LIGHT-ON-APPS/LIGTH-ON-DISPLAY/민석님 lcd 핀맵.png

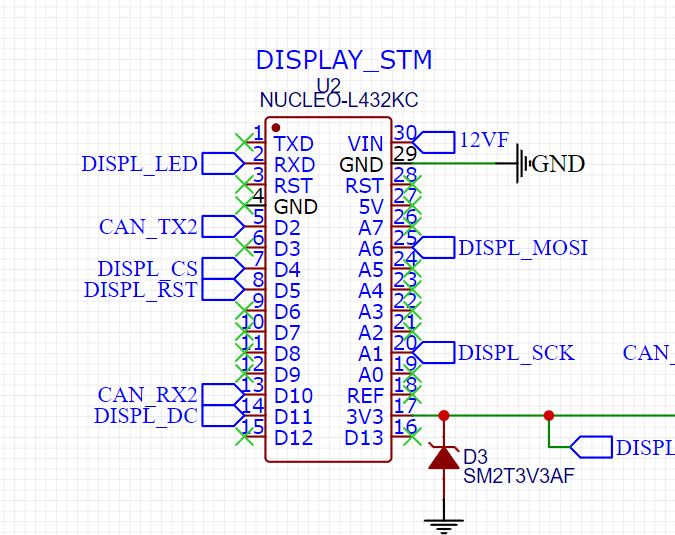
민석님 lcd 핀맵.png
