LIGHT-ON-APPS/LIGTH-ON-DISPLAY/src/common/def.h

/*
 * def.h
 *
 *  Created on: Dec 6, 2020
 *      Author: baram
 *      모두가 공통으로 쓸 헤더파일
 */

#ifndef SRC_COMMON_DEF_H_
#define SRC_COMMON_DEF_H_


#include <stdio.h>
#include <stdint.h>		//uint32_t 같은거 쓰게 해주는 라이브러리
#include <stdbool.h>	//bool 함수
#include <stdarg.h>
#include <string.h>
#include <stdlib.h>

#define _DEF_VER1             0
#define _DEF_VER2             1
#define _DEF_VER3             2
#define _DEF_VER4             3

#define _DEF_VER              _DEF_VER2

#define _DEF_GPIO1            0
#define _DEF_GPIO2            1
#define _DEF_GPIO3            2
#define _DEF_GPIO4            3

#define _DEF_LED1           	0
#define _DEF_LED2           	1
#define _DEF_LED3           	2
#define _DEF_LED4           	3

#define _DEF_UART1          	0
#define _DEF_UART2          	1
#define _DEF_UART3          	2
#define _DEF_UART4          	3

#define	_DEF_SPI1				      0
#define	_DEF_SPI2				      1
#define	_DEF_SPI3				      2
#define	_DEF_SPI4				      3

#define _DEF_BUTTON1			    0
#define _DEF_BUTTON2			    1
#define _DEF_BUTTON3			    2
#define _DEF_BUTTON4			    3

#define _DEF_INPUT				    0
#define	_DEF_INPUT_PULLUP		    1
#define _DEF_INPUT_PULLDOWN		 	2
#define	_DEF_OUTPUT				    3
#define _DEF_OUTPUT_PULLUP		  	4
#define	_DEF_OUTPUT_PULLDOWN	  	5
#define _DEF_OUTPUT_OPEN_DRAIN  	6

#define	_DEF_LOW				      0
#define	_DEF_HIGH				      1

#define _DEF_CAN1             0
#define _DEF_CAN2             1
#define _DEF_CAN3             2
#define _DEF_CAN4             3

#define _DEF_DM1              0
#define _DEF_DM2              1
#define _DEF_DM3              2
#define _DEF_DM4              3

#define _DEF_TIM1             0
#define _DEF_TIM2             1
#define _DEF_TIM3             2
#define _DEF_TIM4             3

#define _DEF_PWM1             0
#define _DEF_PWM2             1
#define _DEF_PWM3             2
#define _DEF_PWM4             3

#define _DEF_ADC1             0
#define _DEF_ADC2             1
#define _DEF_ADC3             2
#define _DEF_ADC4             3

#define constrain(amt,low,high) ((amt)<(low)?(low):((amt)>(high)?(high):(amt)))

#ifndef max
#define max(a,b) (((a) > (b)) ? (a) : (b))
#define min(a,b) (((a) < (b)) ? (a) : (b))
#endif


#ifndef map
#define map(value, in_min, in_max, out_min, out_max) ((value - in_min) * (out_max - out_min) / (in_max - in_min) + out_min)
#endif


#if 0
typedef union
{
  uint8_t  u8Data[4];
  uint16_t u16Data[2];
  uint32_t u32Data;

  int8_t   s8Data[4];
  int16_t  s16Data[2];
  int32_t  s32Data;

  uint8_t  u8D;
  uint16_t u16D;
  uint32_t u32D;

  int8_t   s8D;
  int16_t  s16D;
  int32_t  s32D;
} data_t;
#endif

typedef struct
{
  uint8_t version[32];
  uint8_t name[32];
} firm_version_t;


typedef struct
{
  uint32_t magic_number;

  //-- fw info
  //
  uint32_t addr_tag;
  uint32_t addr_fw;
  uint32_t size_tag;


  //-- tag info
  //
  uint32_t tag_flash_type;
  uint32_t tag_flash_start;
  uint32_t tag_flash_end;
  uint32_t tag_flash_length;
  uint32_t tag_flash_crc;
  uint32_t tag_length;
  uint8_t  tag_date_str[32];
  uint8_t  tag_time_str[32];

} firm_tag_t;


#endif /* SRC_COMMON_DEF_H_ */
