LIGHT-ON-APPS/LIGTH-ON-DISPLAY/src/common/hw/include/lcd.h

/*
 * lcd.h
 *
 *  Created on: Dec 30, 2025
 *      Author: TEMP
 */

#ifndef SRC_COMMON_HW_INCLUDE_LCD_H_
#define SRC_COMMON_HW_INCLUDE_LCD_H_

#include "hw_def.h"


#ifdef _USE_HW_LCD

#define LCD_WIDTH         HW_LCD_WIDTH
#define LCD_HEIGHT        HW_LCD_HEIGHT


#define GETR(c) (((uint16_t)(c)) >> 11)
#define GETG(c) (((c) & 0x07E0)>>5)
#define GETB(c) ((c) & 0x1F)
#define RGB2COLOR(r, g, b) ((((r>>3)<<11) | ((g>>2)<<5) | (b>>3)))


enum class_color
{
 white     = 0xFFFF,
 gray      = 0x8410,
 darkgray  = 0xAD55,
 black     = 0x0000,
 purple    = 0x8010,
 pink      = 0xFE19,
 red       = 0xF800,
 orange    = 0xFD20,
 brown     = 0xA145,
 beige     = 0xF7BB,
 yellow    = 0xFFE0,
 lightgreen= 0x9772,
 green     = 0x07E0,
 darkblue  = 0x0011,
 blue      = 0x001F,
 lightblue = 0xAEDC,
};



typedef struct lcd_driver_t_ lcd_driver_t;
typedef void (*lcd_render_func_t)(int16_t x, int16_t y, int16_t w, int16_t h, uint16_t *p_buf, void *p_arg);

// lcd의 여러가지 드라이버들을 쓸 수도 있는데 이때 드라이버 구조체를 이용해서 드라이버 코드를 함수 포인터의 집합으로 만든후 lcd각각 컨트롤 헤더에서 include한후 initDriver
// 자기 가 갖고 있는 함수들을 함수 포인터로 연결해줌
// 여러개의 컨트롤러도 따라서 쓸 수 있게 할 수 있음
// 조금은 복잡함
typedef struct lcd_driver_t_
{
  bool     (*init)(void);
  bool     (*reset)(void);
  bool     (*setWindow)(int32_t x, int32_t y, int32_t w, int32_t h);
  uint16_t (*getWidth)(void);
  uint16_t (*getHeight)(void);
  bool     (*setCallBack)(void (*p_func)(void));
  bool     (*sendBuffer)(uint8_t *p_data, uint32_t length, uint32_t timeout_ms);
  /* sendBuffer 가 비동기(DMA)로 도는 드라이버는 아직 전송 중인지 알려 준다.
   * 없으면(NULL) sendBuffer 가 돌아온 시점에 전송이 끝난 것으로 본다. */
  bool     (*isTxBusy)(void);

} lcd_driver_t;



bool lcdInit(void);
bool lcdIsInit(void);
bool lcdReset(void);

uint8_t lcdGetBackLight(void);
void    lcdSetBackLight(uint8_t value);

uint32_t lcdReadPixel(uint16_t x_pos, uint16_t y_pos);
void lcdClear(uint32_t rgb_code);
void lcdClearBuffer(uint32_t rgb_code);

// lcd의 일반적인 함수들

bool lcdDrawAvailable(void);
bool lcdRequestDraw(void);
void lcdUpdateDraw(void);
bool lcdSetWindow(uint16_t x, uint16_t y, uint16_t w, uint16_t h);
bool lcdSendBuffer(uint8_t *p_data, uint32_t length, uint32_t timeout_ms);
/* lcdSendBuffer 로 넘긴 블록이 아직 화면으로 나가는 중인지. */
bool lcdIsTxBusy(void);
/* 블록 전송이 끝날 때 불릴 콜백. 부분 프레임버퍼로 그리는 쪽이 다음 블록을
 * 언제 보낼 수 있는지 알기 위해 쓴다. 인터럽트 문맥에서 불린다. */
void lcdSetTransferDoneCallBack(void (*p_func)(void));
bool lcdDrawRectBuffer(int16_t x, int16_t y, int16_t w, int16_t h, lcd_render_func_t p_func, void *p_arg);
void lcdDisplayOff(void);
void lcdDisplayOn(void);

uint32_t lcdGetFps(void);
uint32_t lcdGetFpsTime(void);
uint32_t lcdGetDrawTime(void);

int32_t lcdGetWidth(void);
int32_t lcdGetHeight(void);

uint16_t *lcdGetFrameBuffer(void);
uint16_t *lcdGetCurrentFrameBuffer(void);
void lcdSetDoubleBuffer(bool enable);

void lcdDrawPixel(uint16_t x_pos, uint16_t y_pos, uint32_t rgb_code);
void lcdDrawPixelMix(uint16_t x_pos, uint16_t y_pos, uint32_t rgb_code, uint8_t mix);
void lcdDrawLine(int16_t x0, int16_t y0, int16_t x1, int16_t y1,uint16_t color);
void lcdDrawVLine(int16_t x, int16_t y, int16_t h, uint16_t color);
void lcdDrawHLine(int16_t x, int16_t y, int16_t w, uint16_t color);
void lcdDrawFillRect(int16_t x, int16_t y, int16_t w, int16_t h, uint16_t color);
void lcdDrawFillScreen(uint16_t color);
void lcdDrawRect(int16_t x, int16_t y, int16_t w, int16_t h, uint16_t color);
void lcdDrawFillCircle(int32_t x0, int32_t y0, int32_t r, uint16_t color);
void lcdDrawRoundRect(int32_t x, int32_t y, int32_t w, int32_t h, int32_t r, uint32_t color);
void lcdDrawFillRoundRect(int32_t x, int32_t y, int32_t w, int32_t h, int32_t r, uint32_t color);
void lcdDrawTriangle(int32_t x1, int32_t y1, int32_t x2, int32_t y2, int32_t x3, int32_t y3, uint32_t color);
void lcdDrawString(int x, int y, uint16_t color, const char *str);
void lcdPrintf(int x, int y, uint16_t color,  const char *fmt, ...);



#endif /* _USE_HW_LCD */

#endif /* SRC_COMMON_HW_INCLUDE_LCD_H_ */
