LIGHT-ON-APPS/LIGTH-ON-DISPLAY/src/common/hw/include/spi.h

/*
 * spi.h
 *
 *  Created on: Jun 24, 2026
 *      Author: young
 */

#ifndef SRC_COMMON_HW_INCLUDE_SPI_H_
#define SRC_COMMON_HW_INCLUDE_SPI_H_

#include "hw_def.h"

#ifdef _USE_HW_SPI

#define SPI_MAX_CH          HW_SPI_MAX_CH


#define SPI_MODE0           0
#define SPI_MODE1           1
#define SPI_MODE2           2
#define SPI_MODE3           3


bool spiInit(void);
bool spiBegin(uint8_t ch);
void spiSetDataMode(uint8_t ch, uint8_t dataMode);
void spiSetBitWidth(uint8_t ch, uint8_t bit_width);
void spiSetClockDivider(uint8_t ch, uint16_t divider);

uint8_t  spiTransfer8(uint8_t ch, uint8_t data);
uint16_t spiTransfer16(uint8_t ch, uint16_t data);

bool spiWrite(uint8_t ch, const uint8_t *p_data, uint32_t length, uint32_t timeout);

void spiDmaTxStart(uint8_t ch, uint8_t *p_buf, uint32_t length);
void spiDmaTxTransfer(uint8_t ch, void *buf, uint32_t length, uint32_t timeout) ;
bool spiDmaTxIsDone(uint8_t ch);
void spiAttachTxInterrupt(uint8_t ch, void (*func)());

void spiDmaRxStart(uint8_t ch, uint8_t *p_buf, uint32_t length);
void spiDmaRxTransfer(uint8_t ch, void *buf, uint32_t length, uint32_t timeout);
bool spiDmaRxIsDone(uint8_t ch);
void spiAttachRxInterrupt(uint8_t ch, void (*func)());


#endif

#endif /* SRC_COMMON_HW_INCLUDE_SPI_H_ */
