LIGHT-ON-APPS/LIGTH-ON-DISPLAY/src/common/hw/include/adc.h

/*
 * adc.h
 *
 * ADC driver
 */

#ifndef SRC_COMMON_HW_INCLUDE_ADC_H_
#define SRC_COMMON_HW_INCLUDE_ADC_H_

#ifdef __cplusplus
extern "C" {
#endif

#include "hw_def.h"


#ifdef _USE_HW_ADC

#define ADC_MAX_CH                  HW_ADC_MAX_CH

typedef void (*adc_update_callback_t)(void);

bool adcInit(void);
bool adcIsInit(void);
bool adcUpdate(void);
void adcSetUpdateCallback(adc_update_callback_t callback);

int32_t adcRead(uint8_t ch);
int32_t adcRead8(uint8_t ch);
int32_t adcRead10(uint8_t ch);
int32_t adcRead12(uint8_t ch);
int32_t adcRead16(uint8_t ch);
uint8_t adcGetRes(uint8_t ch);

float adcReadVoltage(uint8_t ch);
float adcConvVoltage(uint8_t ch, uint32_t adc_value);
uint32_t adcReadMillivolts(uint8_t ch);
uint32_t adcConvMillivolts(uint8_t ch, uint32_t adc_value);

#endif


#ifdef __cplusplus
}
#endif

#endif /* SRC_COMMON_HW_INCLUDE_ADC_H_ */
