LIGHT-ON-APPS/LIGTH-ON-DISPLAY/src/common/hw/include/cli.h

/*
 * cli.h
 *
 *  Created on: May 6, 2026
 *      Author: TEMP
 */

#ifndef SRC_COMMON_HW_INCLUDE_CLI_H_
#define SRC_COMMON_HW_INCLUDE_CLI_H_

#include "hw_def.h"


#ifdef _USE_HW_CLI

#define CLI_CMD_LIST_MAX      HW_CLI_CMD_LIST_MAX
#define CLI_CMD_NAME_MAX      HW_CLI_CMD_NAME_MAX

#define CLI_LINE_HIS_MAX      HW_CLI_LINE_HIS_MAX
#define CLI_LINE_BUF_MAX      HW_CLI_LINE_BUF_MAX




typedef struct
{
  uint16_t   argc;
  char     **argv;

  int32_t  (*getData)(uint8_t index);
  float    (*getFloat)(uint8_t index);
  char    *(*getStr)(uint8_t index);
  bool     (*isStr)(uint8_t index, const char *p_str);
} cli_args_t;

typedef bool (*cli_run_check_t)(void);


bool cliInit(void);
bool cliOpen(uint8_t ch, uint32_t baud);
bool cliClose(void);
bool cliOpenLog(uint8_t ch, uint32_t baud);
void cliSetRunCheck(cli_run_check_t run_check);
bool cliMain(void);
void cliPrintf(const char *fmt, ...);
bool cliAdd(const char *cmd_str, void (*p_func)(cli_args_t *));
bool cliKeepLoop(void);
uint32_t cliAvailable(void);
uint8_t  cliRead(void);
uint32_t cliWrite(uint8_t *p_data, uint32_t length);

#endif

#endif /* SRC_COMMON_HW_INCLUDE_CLI_H_ */
