LIGHT-ON-APPS/LIGTH-ON-DISPLAY/src/common/hw/include/uart.h

/*
 * uart.h
 *
 *  Created on: May 6, 2026
 *      Author: TEMP
 */

#ifndef SRC_COMMON_HW_INCLUDE_UART_H_
#define SRC_COMMON_HW_INCLUDE_UART_H_

#include "hw_def.h"


#ifdef _USE_HW_UART

#define UART_MAX_CH         HW_UART_MAX_CH


bool     uartInit(void);
bool     uartOpen(uint8_t ch, uint32_t baud);
bool     uartClose(uint8_t ch);
uint32_t uartAvailable(uint8_t ch);
uint8_t  uartRead(uint8_t ch);
uint32_t uartWrite(uint8_t ch, uint8_t *p_data, uint32_t length);
uint32_t uartPrintf(uint8_t ch, char *fmt, ...);
uint32_t uartGetBaud(uint8_t ch);

#endif

#endif /* SRC_COMMON_HW_INCLUDE_UART_H_ */
