LIGHT-ON-APPS/LIGTH-ON-DISPLAY/(commit log)

2026-08-25 계기판 표시/CAN 수신 안정화, 폰트 교체
    미커밋으로 쌓여 있던 작업을 한 번에 정리한다.
    표시
    - 폰트를 BarlowCondensed 에서 SairaCondensed 로 교체하고 타이포 위계를
    다시 잡았다. 배터리 잔량을 64 -> 52 로 내려 RPM(68)과 무게가 겹치지
    않게 했다.
    - 온도 타일에 모서리 이미지(정상/경고/위험)를 도입해 임계 상태를 면으로
    보여 준다. 생성 스크립트는 tools/make_corner_images.py.
    - 온도 값에서 소수점을 없애고 반올림해 정수로 띄운다. 값 텍스트가 가운데
    정렬이라 100.5 처럼 세 자리 + 소수점이 되면 왼쪽 이니셜(M/I/C)과
    오른쪽 단위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
2026-08-25 Bamocar 모터 온도 변환, 회전수 풀스케일, 0xA8 오식별 정정
    눈금의 근거를 전부 NDrive 설치본의 1차 자료로 맞춘다
    (settings/regid.txt, settings/units.txt,
    manuals/"BAMOCAR - Temperature and VdcBus Tables").
    모터 온도 (0x49)
    - 지금까지 원시 Num 을 그대로 통과시켜 계기판 M 칸에 1080 같은 숫자가
    떴다. EMRAX 228 의 권선 센서는 KTY 81/210 이므로(228 데이터시트 v1.6)
    위 매뉴얼 4/4 쪽 KTY81-2xx 열 39점(-35~155 C)을 표로 넣고 보간한다.
    관측된 raw 10800 은 25.0 C 로, 같은 순간 인버터가 읽던 22 C 와 맞는다.
    - 표의 Tigbt NTC-infin 열이 기존 IGBT 표와 한 값도 틀리지 않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
2026-08-25 실토크(0xA0) 수신 추가
    APPS 요청 목록에 0xA0(REGID_TORQUE_OUT)과 0xCE(NMAX)를 넣기로 해서,
    받는 쪽을 먼저 맞춘다.
    - 0xA0 을 디코딩해 bamocar_torque_raw 로 둔다. 32767 이 무엇에 대응하는지
    (장치 전류 기준으로 보이나) 아직 확인하지 못해 환산하지 않고 원시값으로
    남기고, CLI 진단에만 쓴다. 계기판에는 띄우지 않는다.
    - 0xCE 수신부는 이미 앞 커밋에 들어가 있다. 요청이 붙으면 그때부터 회전수
    환산의 분모가 기본값 6500 대신 실제 NMAX 로 바뀐다.
2026-08-25 0xA8 미수신을 정지로 오해하지 않게 표기
    APPS 요청 목록에서 0xA8 을 뺐다(0x30 과 같은 회전수라 주기 슬롯만 먹었다).
    디코더 자체는 남긴다 — 계기판은 0x181 을 엿듣는 쪽이라, 누가 다시 요청하면
    그대로 동작한다.
    다만 안 오는 값을 CLI 가 0 rpm 으로 찍으면 모터가 멈춘 것처럼 읽힌다.
    valid_mask 를 보고 미수신이면 그렇다고 말한다.
2026-08-26 fix : 버그 수정
    [telemetry.c]
2026-08-26 드라이버 피드백 수정
2026-08-26 화면 칩 초기화 부팅속도 늦추기
2026-08-26 cli lcdReset 메뉴 추가
2026-08-27 부팅 2번으로 수정
2026-08-27 부팅 순서 바꿈
2026-11-14 README 추가
